ExperimentalDesignBureau-1571/fpv-ground-control-station/Універсальний_кейс_та_корпус_станції/README_EN.md

[🇺🇸 Read in English](README_EN.md) | [🇺🇦 Читати Українською](README.md)

# Universal Case and Station Body

The design of the universal case is developed as a balanced solution for transporting and deploying an FPV drone ground control station in field conditions. The primary focus of the design is on combining reliability, mobility, and manufacturing accessibility.

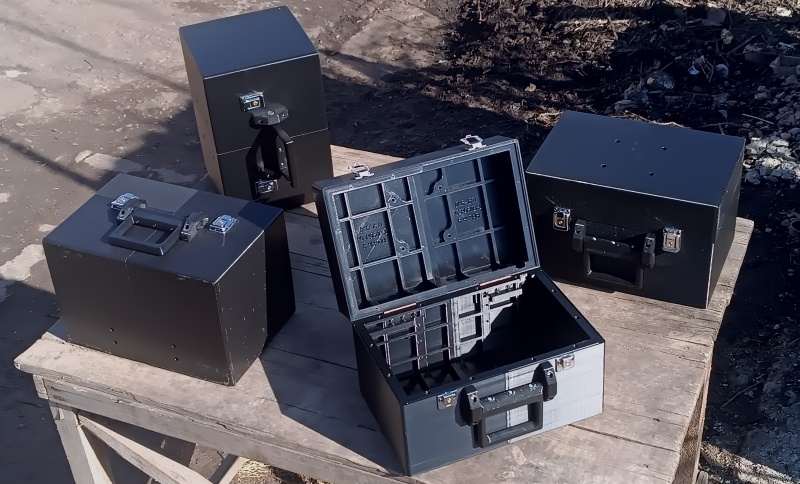
[picture p10: Універсальний_кейс_та_корпус_станції/Фото/general_view_of_finished_cases.jpg]
General view of finished cases


## Key Design Features:
<ul>
<li><b>Compactness and Mobility:</b> The body dimensions are optimized to ensure maximum operator mobility. The compact form factor allows the station to be conveniently transported in a backpack or as a separate small-sized equipment unit.</li>

<li><b>Optimization for Additive Manufacturing:</b> The geometry of the parts is designed for 3D printing on most common FDM printers. The maximum dimensions of individual elements do not exceed 250 × 250 × 250 mm, making the project accessible for implementation on budget equipment.</li>

<li><b>Economic Efficiency:</b> The development follows the principle of maximizing production cost reduction. The use of affordable materials (plastics like PETG/ABS) and standard hardware (fasteners) significantly lowers the cost of the finished product without sacrificing functionality.</li>

<li><b>Operational Durability and Repeatability:</b> The structure has a sufficient safety margin for intensive use. Technical solutions allow for easy replication of the body in local or field workshops.</li>

<li><b>Modular Architecture and Maintainability:</b></li>
<ul>
<li>The body consists of individual interchangeable modules.</li>

<li>High maintainability: in case of mechanical damage, it is sufficient to replace only the specific affected element.</li>

<li>Standardization of fasteners: Most connections are implemented using standard metric fasteners (M3 screws and nuts), simplifying assembly and component logistics.</li>
</ul>
</ul>

## Required Components for Manufacturing One Universal Case / Station Body

| Name | Type/Size | Quantity | Note |
|:---: | :---: | :---: |:---: |
| Self-tapping screw | 2x8 DIN 7982 | 12 pcs | If using the case as a station body |
| Screw | M3x14 DIN 7985 | 48 pcs | |
| Screw | M3x20 DIN 7985 A2 | 10 pcs | If using the case as a station body |
| Screw | M3x25 DIN 912 | 7 pcs | |
| Screw | M4x12 DIN 7985 | 4 pcs | If using the case as a station body |
| Nut | M3 DIN 934 | 65 pcs | |
| Washer | M3 DIN 125 | 18 pcs | |
| Lock with key | А-014/2 | 2 pcs | [Purchase lock with key А-014/2](https://prom.ua/ua/p2153719864-zamok-klyuchem-0142.html) |
| Hinges | В-114 | 2 pcs | [Purchase hinges В-114](https://prom.ua/ua/p779613844-petlya-114.html) |
| Part 1 |  | 1 pc | |
| Part 2 |  | 1 pc | |
| Part 3 |  | 1 pc | If using the case as a station body |
| Part 4 |  | 1 pc | If using the case as a station body |
| Part 5 |  | 1 pc | |
| Part 6 |  | 1 pc | |
| Part 7 |  | 2 pcs | |
| Part 8 |  | 1 pc | |
| Part 9 |  | 1 pc | |

## 3D Printing Settings and Material

| Parameter | Value |
| :---: | :---: |
| Perimeters | 5 |
| Top/Bottom solid layers | 5 |
| Infill density | 40% |
| Infill pattern | Gyroid |
| Supports | Tree |

Material: coPET black MonoFilament

## Detailed Hardware Allocation

| Name | Type/Size | Quantity | Note |
| :---: | :---: | :---: | :---: |
| Screw | M3x14 DIN 7985 | 11 pcs | Connecting Part 1 and Part 2 |
| Nut | M3 DIN 934 | 11 pcs | Connecting Part 1 and Part 2 |

Part 1 and Part 2

| Name | Type/Size | Quantity | Note |
| :---: | :---: | :---: | :---: |
| Screw | M3x14 DIN 7985 | 17 pcs | Connecting Part 5 and Part 6 |
| Nut | M3 DIN 934 | 17 pcs | Connecting Part 5 and Part 6 |

Part 5 and Part 6

| Name | Type/Size | Quantity | Note |
| :---: | :---: | :---: | :---: |
| Screw | M3x14 DIN 7985 | 8 pcs | Attaching locks to the top cover and the base of the case |
| Nut | M3 DIN 934 | 8 pcs | Attaching locks to the top cover and the base of the case |

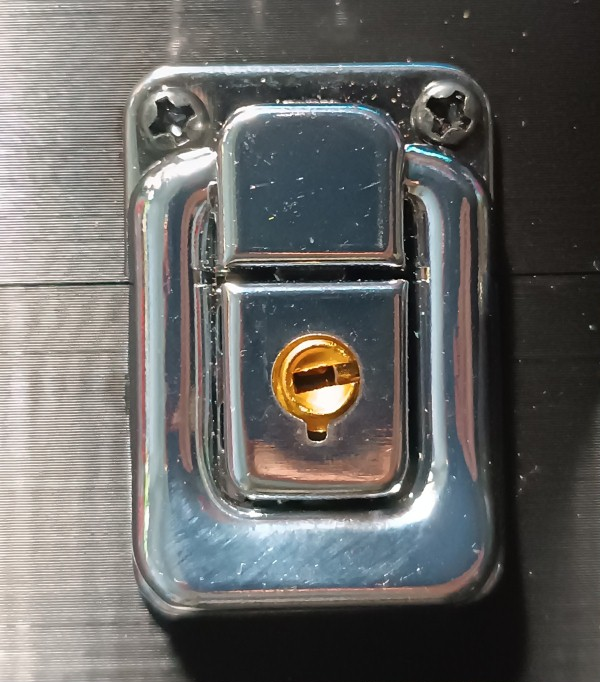
[picture p11: Універсальний_кейс_та_корпус_станції/Фото/fastening_the_lock.jpg]
Attaching locks


| Name | Type/Size | Quantity | Note |
| :---: | :---: | :---: | :---: |
| Screw | M3x14 DIN 7985 | 12 pcs | Attaching hinges to the top cover and the base of the case |
| Nut | M3 DIN 934 | 12 pcs | Attaching hinges to the top cover and the base of the case |
| Washer | M3 DIN 125 | 12 pcs | Attaching hinges to the top cover and the base of the case |

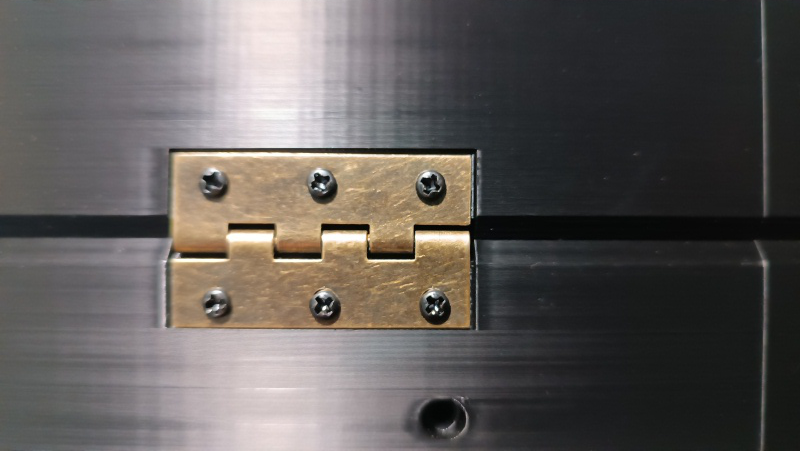
[picture p12: Універсальний_кейс_та_корпус_станції/Фото/hinge_attachment_1.jpg]
Hinge attachment 1
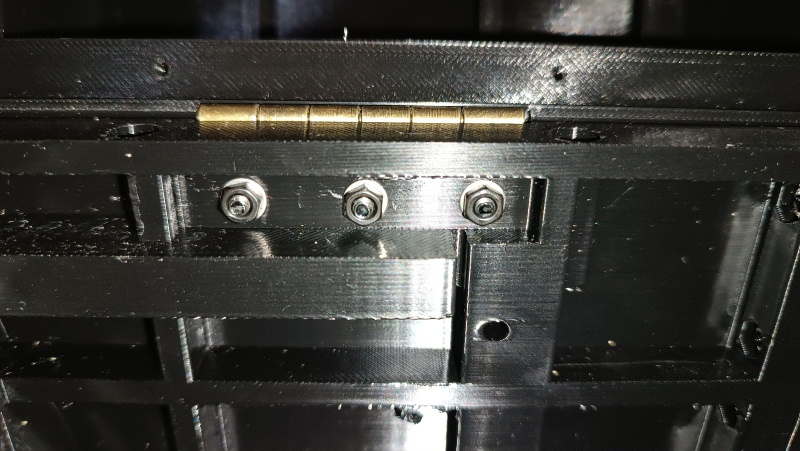
[picture p13: Універсальний_кейс_та_корпус_станції/Фото/hinge_attachment_2.jpg]
Hinge attachment 2
 

| Name | Type/Size | Quantity | Note |
| :---: | :---: | :---: | :---: |
| Screw | M3x25 DIN 912 | 3 pcs | Connecting Part 8 and Part 9 |
| Nut | M3 DIN 934 | 3 pcs | Connecting Part 8 and Part 9 |
| Washer | M3 DIN 125 | 6 pcs | Connecting Part 8 and Part 9 |

Part 8 and Part 9

| Name | Type/Size | Quantity | Note |
| :---: | :---: | :---: | :---: |
| Screw | M3x25 DIN 912 | 4 pcs | Connecting Part 7 to the base of the case |
| Nut | M3 DIN 934 | 4 pcs | Connecting Part 7 to the base of the case |

Connecting Part 7 to the base

| Name | Type/Size | Quantity | Note |
| :---: | :---: | :---: | :---: |
| Screw | M3x20 DIN 7985 A2 | 10 pcs | Attaching the Control Unit to the base of the case |
| Nut | M3 DIN 934 | 10 pcs | Attaching the Control Unit to the base of the case |

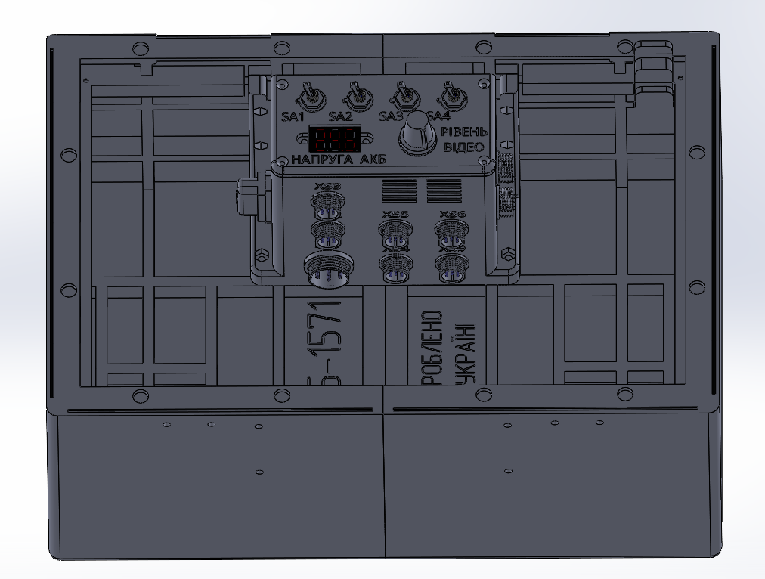
[picture p14: Універсальний_кейс_та_корпус_станції/picture/fastening_the_control_unit_to_the_base.png]
Attaching the Control Unit to the base


| Name | Type/Size | Quantity | Note |
| :---: | :---: | :---: | :---: |
| Screw | M4x12 DIN 7985 | 4 pcs | Attaching the monitor to the top cover of the case |

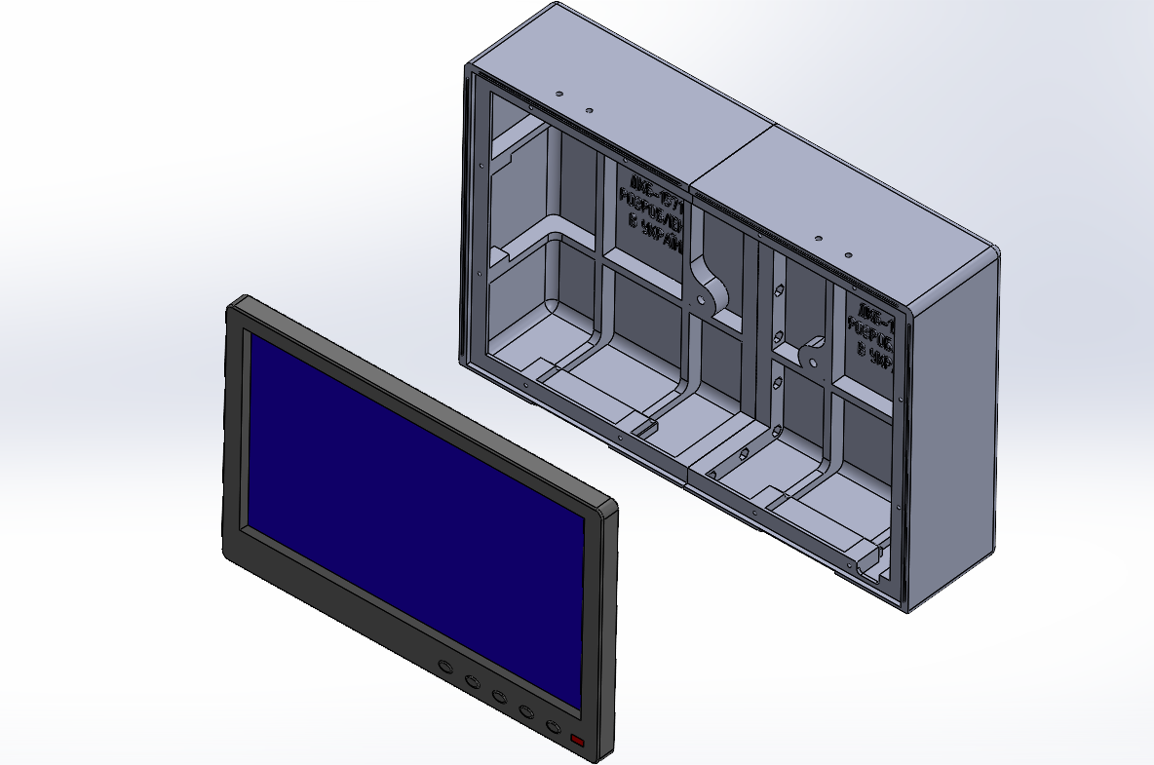
[picture p15: Універсальний_кейс_та_корпус_станції/picture/attaching_the_monitor_to_the_top_cover.png]
Attaching the monitor to the top cover


| Name | Type/Size | Quantity | Note |
| :---: | :---: | :---: | :---: |
| Self-tapping screw | 2x8 DIN 7982 | 6 pcs | Attaching Part 3 to Part 1 |
| Self-tapping screw | 2x8 DIN 7982 | 6 pcs | Attaching Part 4 to Part 2 |

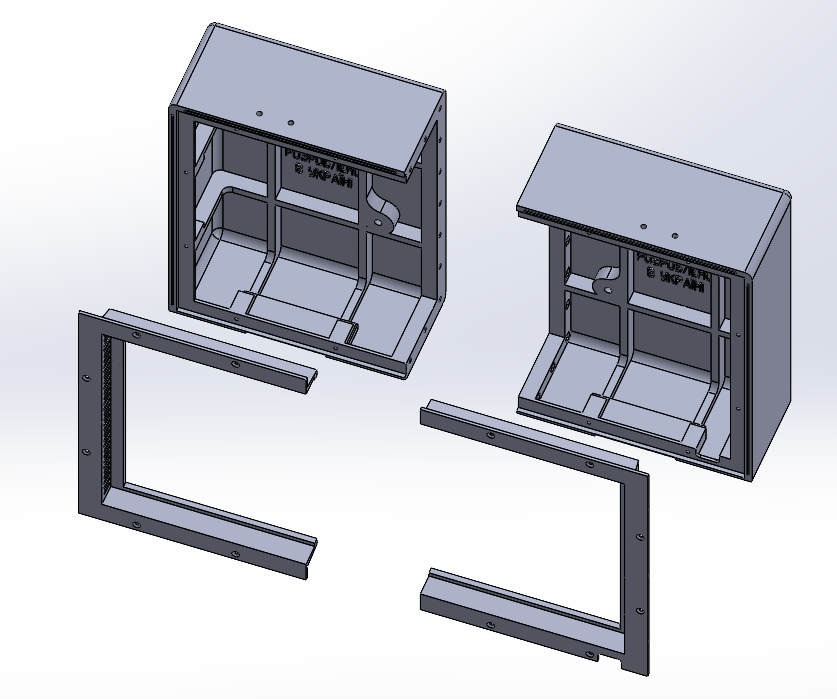
[picture p16: Універсальний_кейс_та_корпус_станції/Фото/fastening_parts_3_and_4_to_parts_1_and_2.png]
Attaching Parts 3 and 4
