ExperimentalDesignBureau-1571/fpv-ground-control-station/Підсистема керування/Адаптер JR-модуля/README.md

[🇺🇸 Read in English](README_EN.md) | [🇺🇦 Читати Українською](README.md)

# Адаптер JR-модуля

Адаптер JR-модуля забезпечує можливість підключення пульта керування з JR-сумісним відсіком до блоку керування станцією для подальшого двостороннього обміну інформацією з передавачем керування на виносному блоці станції.

Загальний вигляд JR-модуля

## Короткі технічні параметри

| Параметр | Значення | Примітка |
|---|---|---|
| Протокол керування | CRSF | Через S.Port |
| Інтерфейс передачі | Диференційний сигнал стандарту RS-485 | |
| Режим роботи | Двосторонній | Керування + телеметрія |
| Живлення адаптера JR-модуля | 5–8.4 В | Від пульта керування |
| Охолодження | Пасивне | Радіатори + вентиляційні отвори |
| Екранування | Часткове | |

### Інтерфейси

| Роз’єм | Призначення | Основні сигнали | Примітка |
|---|---|---|---|
| XS1 | Підключення до пульта керування | +BAT, GND, CRSF | Пульт керування має бути обладнаний JR-сумісним відсіком |
| XS2 | Підключення до блоку керування станцією | Диференційний сигнал стандарту RS-485, GND | |

## Схемотехніка та функціонал адаптера JR-модуля

Живлення адаптера здійснюється безпосередньо від пульта керування через роз’єм XS1 у діапазоні 5В–8,4В.

Високошвидкісний сигнал від пульта керування через вивід S.Port (протокол CRSF) роз’єму XS1 надходить на конвертер інтерфейсів (модуль BARVINOK-5 RS-485 nano V2.1), який перетворює його в диференційний сигнал стандарту RS-485 та через роз’єм XS2 видає в комутаційні лінії наземної станції. 

Стабілізацію температурних режимів пристрою забезпечує пасивна система охолодження, що складається з вентиляційних отворів у корпусі, силіконової термопрокладки та мідного радіатора. Радіатор електрично з’єднаний із загальним проводом (GND), що дозволяє йому виконувати функцію додаткового екрана для захисту від електромагнітних завад.

Принципова схема JR-модуля

## Перелік необхідних комплектуючих для виготовлення одного адаптера JR-модуля

| Найменування | Кількість| Примітка |
| :--- | :--- | :---: |
| Модуль конвертора інтерфейсів BARVINOK-5 RS-485 nano V2.1 | 1 штука | Модуль Українського виробництва [придбати BARVINOK-5 RS-485 nano V2.1 у виробника](https://prom.ua/ua/p2693881056-adapter-port-485.html) |
| Роз'єм PCE-C-05 | 1 штука | XS1 |
| Вилка блочна GX12-6 pin (male) | 1 штука | XS2 |
| Макетна плата під пайку двостороння з кроком 2,54 мм | 30 мм х 70 мм |  |
| Листова мідь товщиною 0.8 мм | 25 мм х 28 мм |  |
| Силіконова термопрокладка 2 мм 6W\m.k | 25 мм х 28 мм |  |
| Провід мідний 26 AWG з силіконовою ізоляцією чорний | 260 мм |  |
| Провід мідний 26 AWG з силіконовою ізоляцією зелений | 170 мм |  |
| Провід мідний 26 AWG з силіконовою ізоляцією синій | 170 мм |  |
| Гвинт M2x5 DIN 7985 | 2 штуки |  |
| Гвинт M2x6 DIN 965 | 3 штуки |  |
| Гвинт M2x10 DIN 7985 | 9 штук |  |
| Шайба M2 DIN 125 | 8 штук |  |
| Гайка M2 DIN 934 | 14 штук |  |
| Гвинт M3x8 DIN 965 | 2 штуки |  |
| Гайка M3 DIN 934 | 2 штуки |  |
| Деталь 1 - 3D друк | 1 штука |  |
| Деталь 2 - 3D друк | 1 штука |  |
| Деталь 3 - 3D друк | 1 штука |  |
| Деталь 4 - 3D друк | 1 штука |  |

## Налаштування 3Д-друку та використаний матеріал

| Параметр | Значення |
| :---: | :---: |
| Кількість периметрів | 4 |
| Суцільних шарів зверху і знизу | 5 |
| Щільність заповнення | 40% |
| Малюнок заповнення | Гіроїд |
| Підтримка | Деревоподібна |

Матеріал coPET black MonoFilament

## Деталізація по витраті метизів

| Найменування | Тип/Розмір | Кількість | Примітка |
| :--- | :--- | :---: | :---: |
| Гвинт | M2x5 DIN 7985 | 2 штуки | Кріплення плати з роз'ємом XS1 |
| Гайка | M2 DIN 934 | 2 штуки | Кріплення плати з роз'ємом XS1 |
| Гвинт | M2x10 DIN 7985 | 1 штука | Кріплення фіксатора роз'єму XS1 |
| Гайка | M2 DIN 934 | 1 штука | Кріплення фіксатора роз'єму XS1 |
| Гвинт | M3x8 DIN 965 | 2 штуки | Кріплення модуля BARVINOK-5 RS-485 nano V2.1 |
| Гайка | M3 DIN 934 | 2 штуки | Кріплення модуля BARVINOK-5 RS-485 nano V2.1 |
| Гвинт | M2x5 DIN 7985 | 4 штуки | Кріплення радіатора |
| Шайба | M2 DIN 125 | 4 штуки | Кріплення радіатора |
| Гайка | M2 DIN 934 | 4 штуки | Кріплення радіатора |
| Гвинт | M2x6 DIN 965 | 3 штуки | Кріплення внутрішньої планки до основи модуля |
| Гайка | M2 DIN 934 | 3 штуки | Кріплення внутрішньої планки до основи модуля |
| Гвинт | M2x10 DIN 7985 | 4 штуки | Кріплення кришки модуля до його основи |
| Шайба | M2 DIN 125 | 4 штуки | Кріплення кришки модуля до його основи |
| Гайка | M2 DIN 934 | 4 штуки | Кріплення кришки модуля до його основи |

## Деталізація по витраті проводу
| Тип | Довжина | Примітка |
| :--- | :--- | :---: |
| 26 AWG чорний | 80 мм | XS1 - конвертор інтерфейсів |
| 26 AWG зелений | 80 мм | XS1 - конвертор інтерфейсів |
| 26 AWG синій | 80 мм | XS1 - конвертор інтерфейсів |
| 26 AWG чорний | 90 мм | Конвертор інтерфейсів - XS2 |
| 26 AWG зелений | 90 мм | Конвертор інтерфейсів - XS2 |
| 26 AWG синій | 90 мм | Конвертор інтерфейсів - XS2 |
| 26 AWG чорний | 90 мм | XS2 - радіатор |
