ExperimentalDesignBureau-1571/fpv-ground-control-station/Виносний_блок/Кронштейн виносного блоку/README_EN.md

[🇺🇸 Read in English](README_EN.md) | [🇺🇦 Читати Українською](README.md)

# Remote Unit Bracket

The bracket is designed for mounting the ground control station's remote unit on a mast or other supporting structures. The bracket is part of the mechanical integration system of the remote unit. The design is oriented towards field operation and transportation. The general view of the remote unit with additional antennas fixed via the bracket on a mast is shown in the picture.

General view of the remote unit with additional antennas on the mast

The bracket design ensures:
- rapid deployment
- fixing the remote unit
- mounting rods for installing additional antenna systems or equipment
- increasing the antenna installation height
- expanding the antenna configuration according to operating conditions

## Short Technical Parameters

| Parameter | Value | Note |
|---|---|---|
| Mounting Type | On a mast | Metal clamps |
| Design Type | Modular | |
| Rods for additional antennas and equipment | Interchangeable | |

## List of Required Components for Manufacturing One Bracket

| Name | Quantity | Note |
| :--- | :--- | :---: |
| Screw | M3x35 DIN 7985 | 2 pcs | |
| Screw | M3x40 DIN 7985 | 4 pcs | |
| Screw | M3x50 DIN 7985 | 6 pcs | |
| M3 DIN 9021 Washer | 24 pcs | |
| M3 DIN 315 Wing nut | 12 pcs | |
| Tightening clamp 28-48 mm DIN3017-1 | 3 pcs | |
| Aluminum profile pipe 20x20x2 mm | 500 mm | |
| Part 1 - 3D print | 1 pc | |
| Part 2 - 3D print | 1 pc | |
| Part 3 - 3D print | 1 pc | |
| Part 4 - 3D print | 1 pc | |

## 3D Printing Settings and Material

| Parameter | Value |
| :---: | :---: |
| Perimeters | 4 |
| Top/Bottom solid layers | 5 |
| Infill density | 40% |
| Infill pattern | Gyroid |
| Supports | Tree |

Material: coPET black MonoFilament

## Hardware Usage Detail

| Name | Type/Size | Quantity | Note |
| :--- | :--- | :---: | :---: |
| Screw | M3x40 DIN 7985 | 4 pcs | Attaching rods to the bracket |
| Washer | M3 DIN 9021 | 8 pcs | Attaching rods to the bracket |
| Wing nut | M3 DIN 315 | 4 pcs | Attaching rods to the bracket |
| Screw | M3x50 DIN 7985 | 2 pcs | Attaching the control antenna bracket |
| Washer | M3 DIN 9021 | 4 pcs | Attaching the control antenna bracket |
| Wing nut | M3 DIN 315 | 2 pcs | Attaching the control antenna bracket |
| Screw | M3x35 DIN 7985 | 2 pcs | Attaching the helical antenna bracket |
| Washer | M3 DIN 9021 | 4 pcs | Attaching the helical antenna bracket |
| Wing nut | M3 DIN 315 | 2 pcs | Attaching the helical antenna bracket |
| Screw | M3x50 DIN 7985 | 4 pcs | Attaching the bracket to the concentrator |
| Washer | M3 DIN 9021 | 8 pcs | Attaching the bracket to the concentrator |
| Wing nut | M3 DIN 315 | 4 pcs | Attaching the bracket to the concentrator |
| Tightening clamp | Tightening clamp 28-48 mm DIN3017-1 | 3 pcs | Attaching the bracket to the mast |
