ExperimentalDesignBureau-1571/fpv-ground-control-station/Виносний_блок/Універсальна_рамка/README_EN.md

[🇺🇸 Read in English](README_EN.md) | [🇺🇦 Читати Українською](README.md)

# Universal Frame

The universal frame is designed for the mounting and mechanical integration of the remote unit concentrator and peripheral devices. The remote unit concentrator, along with the peripheral devices installed on the universal frame, forms the ground station's remote unit.

The design of the frame ensures:
- installation of the remote unit concentrator
- installation of TX and VRX blocks
- unified mounting of system components
- quick transition of the remote unit between transport and working positions

General view of the remote unit

## Design Features

- The design has a modular architecture
- Provision is made for the installation of interchangeable TX and VRX blocks
- All modules are fixed with screw connections
- The design ensures resistance to mechanical loads and vibrations

## Transport Position

The transport position of the remote unit in the ground station case provides for:
- dismounted stand
- absence of a VRX block in the additional slot
- fixed position of peripheral devices

Transport position of the remote unit

## List of Required Components for Manufacturing One Universal Frame

| Name | Quantity | Note |
| :--- | :--- | :---: |
| M2x10 DIN 7985 Screw | 12 pcs | Peripheral device mounting |
| M2 DIN 934 Nut | 12 pcs | Peripheral device mounting |
| M3x14 DIN 7985 A2 Screw | 2 pcs | Remote unit handle mounting |
| M3x20 DIN 7985 A2 Screw | 2 pcs | Stand mounting |
| M3x30 DIN 965 Screw | 5 pcs | Mounting the universal frame to the concentrator |
| M3 DIN 934 Nut | 9 pcs | Mounting the universal frame to the concentrator, stand mounting, remote unit handle mounting |
| M3 DIN 315 Wing nut | 2 pcs | Stand mounting |
| 2x8 DIN 7982 Self-tapping screw | 2 pcs | Antenna holder mounting |
| Part 1 - 3D print | 1 pc |  |
| Part 2 - 3D print | 1 pc |  |
| Part 3 - 3D print | 1 pc |  |
| Part 4 - 3D print | 1 pc |  |

## 3D Printing Settings and Material

| Parameter | Value |
| :---: | :---: |
| Perimeters | 4 |
| Top/Bottom solid layers | 5 |
| Infill density | 40% |
| Infill pattern | Gyroid |
| Supports | Tree |

Material: coPET black MonoFilament
