ExperimentalDesignBureau-1571/fpv-ground-control-station/Підсистема керування/Адаптер JR-модуля/temp.md

# Загальний опис

Адаптер JR-модуля забезпечує можливість підключення пульта керування з JR-сумісним відсіком до блоку керування станцією для подальшого двостороннього обміну інформацією з передавачем керування на виносному блоці станції.

Загальний вигляд JR-модуля

## Схемотехніка та функціонал адаптера JR-модуля

Живлення адаптера здійснюється безпосередньо від пульта керування через роз’єм XS1 у діапазоні 5В–8,4В.

Високошвидкісний сигнал від пульта керування через вивід S.Port (протокол CRSF) роз’єму XS1 надходить на конвертер інтерфейсів (модуль BARVINOK-5 RS-485), який перетворює його в диференційний сигнал стандарту RS-485 та через роз’єм XS2 видає в комутаційні лінії наземної станції. 

Стабілізацію температурних режимів пристрою забезпечує пасивна система охолодження, що складається з вентиляційних отворів у корпусі, силіконової термопрокладки та мідного радіатора. Радіатор електрично з’єднано із загальним проводом (GND), що дозволяє йому виконувати функцію додаткового екрана для захисту від електромагнітних завад.

Принципова схема JR-модуля

## Перелік необхідних комплектуючих для виготовлення одного JR-модуля

| Найменування | Кількість| Примітка |
| :--- | :--- | :---: |

## Налаштування 3Д-друку та використаний матеріал

| Параметр | Значення |
| :---: | :---: |
| Кількість периметрів | 4 |
| Суцільних шарів зверху і знизу | 5 |
| Щільність заповнення | 40% |
| Малюнок заповнення | Гіроїд |
| Підтримка | Деревоподібна |

Матеріал coPET black MonoFilament

## Деталізація по витраті метизів

| Найменування | Тип/Розмір | Кількість | Примітка |
| :--- | :--- | :---: | :---: |

## Деталізація по витраті проводу
| Тип | Довжина | Примітка |
| :--- | :--- | :---: |
| 20 AWG чорний | 100 мм | XS1 - шина GND модуля розподілу живлення |
