ExperimentalDesignBureau-1571/fpv-ground-control-station/Блоки_VRX/README.md

[🇺🇸 Read in English](README_EN.md) | [🇺🇦 Читати Українською](README.md)

# Блоки VRX

Розділ містить документацію, 3D-моделі, принципові схеми та інструкції з виготовлення змінних блоків прийому відеосигналу (VRX блоків), що використовуються у складі наземної станції керування. Кожен VRX блок є функціонально завершеним модулем, призначеним для роботи в певному частотному діапазоні, стандарті передачі або з конкретним типом відеоприймального обладнання.

## Призначення

VRX блоки забезпечують:
- прийом відеосигналу
- передачу вихідного відеосигналу в комутаційні лінії наземної станції
- механічну інтеграцію відеоприймального обладнання у виносний блок станції
- уніфіковане підключення живлення та сигнальних ліній

## Архітектура та особливості реалізації

### Архітектура допускає використання:
<ul>
<li>аналогових відеоприймачів</li>
<li>цифрових відеоприймальних систем в комбінації з конвертором відеосигналу</li>
<li>керування відеоприймачем через комутаційні лінії наземної станції</li>
</ul>

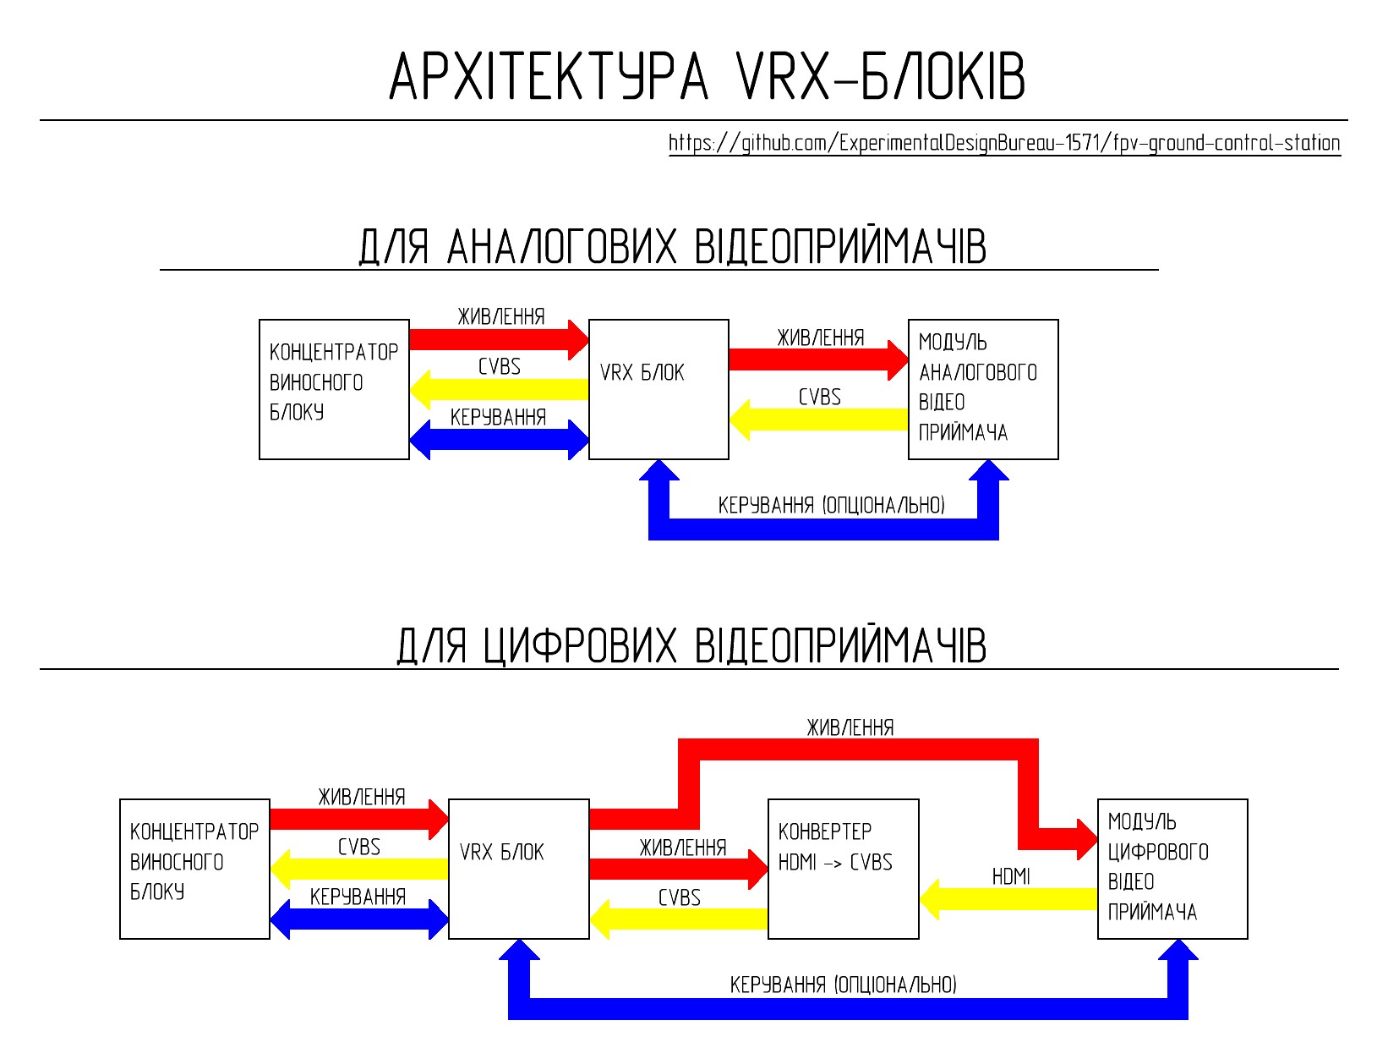
[picture p26: Блоки_VRX/VRX_block_architecture.JPG]
Блок-схема архітектури VRX блоків


### Особливості реалізації
<ul>
<li>Всі VRX блоки мають уніфіковане підключення до концентратора виносного блоку </li>
<li>Нові VRX блоки інтегруються в наземну станцію без зміни архітектури інших підсистем</li>
<li>Кожен VRX блок проектується під конкретний тип відеоприймального обладнання або стандарт передачі </li>
<li>Конструкція забезпечує заміну VRX блоків без модифікації інших компонентів станції </li>
</ul>
