ExperimentalDesignBureau-1571/fpv-ground-control-station/Підсистема керування/README.md

[🇺🇸 Read in English](README_EN.md) | [🇺🇦 Читати Українською](README.md)

# Підсистема керування

Підсистема керування забезпечує двосторонній обмін даними через комутаційні лінії наземної станції за стандартом RS-485 між пультом керування оператора та передавачем керування, що встановлений у виносному блоці наземної станції.

До складу підсистеми керування входять:
- Адаптер JR-модуля (зі сторони пульта керування)
- Блок TX (зі сторону виносного блоку)

## Короткі технічні параметри

| Параметр | Значення | Примітка |
|---|---|---|
| Протокол керування | CRSF | Через S.Port |
| Інтерфейс передачі | Диференційний сигнал стандарту RS-485 | Стійкий до завад, довгі лінії |
| Канал передачі даних | Комутаційні лінії наземної станції | Максимальна довжина залежить від типу кабеля |
| Режим роботи | Двосторонній | Керування + телеметрія |
| Живлення адаптера JR-модуля | 5–8.4 В | Від пульта керування |
| Живлення блоку TX | Від концентратора виносного блоку | Через XS2 |
| Живлення модуля TX передавача керування | 8В | Від блоку ТХ |
| Вихідна напруга блоку TX через роз'єм XS3 | 8В | Максимальний довготривалий струм 2А |
| Охолодження | Пасивне | Радіатори + вентиляційні отвори |
| Екранування | Часткове | |

## Принцип роботи та архітектура

Сигнал керування від пульта надходить на адаптер JR-модуля, де перетворюється в диференційний сигнал стандарту RS-485. Далі сигнал передається через комутаційні лінії наземної станції до блоку TX, де відбувається зворотне перетворення в сигнал протоколу CRSF перед подачею на передавач керування. Зворотний канал (телеметрія) працює аналогічно у протилежному напрямку.

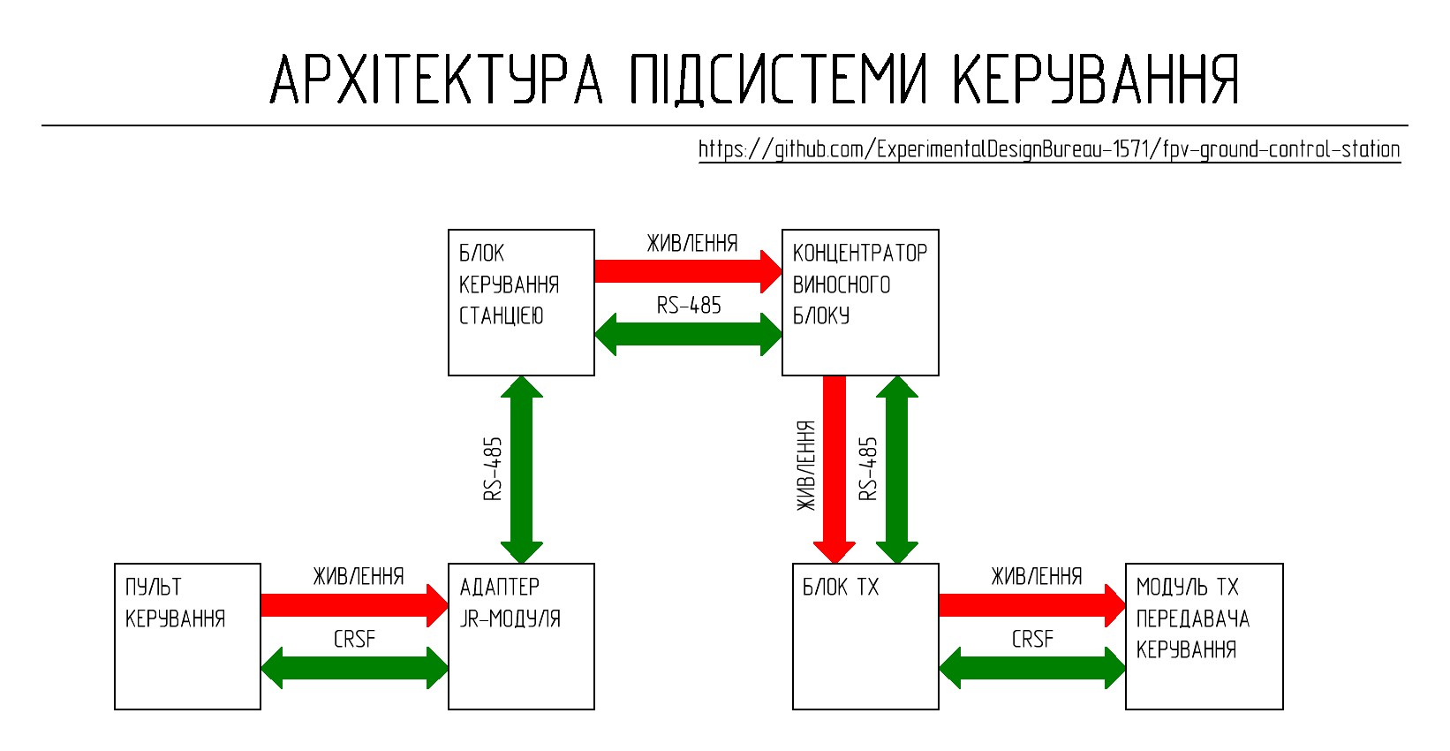
[picture p27: Підсистема керування/control_subsystem_architecture_block_diagram.JPG]
Блок-схема архітектури підсистеми керування


Детальна реалізація кожного пристрою підсистеми керування наведена у відповідних розділах:

* **[Адаптер JR-модуля](Адаптер%20JR-модуля/)**
* **[Блок TX](Блок%20TX/)**
