ExperimentalDesignBureau-1571/fpv-ground-control-station/Виносний_блок/README.md

[🇺🇸 Read in English](README_EN.md) | [🇺🇦 Читати Українською](README.md)

# Виносний блок

Виносний блок є функціональним вузлом наземної станції керування, призначеним для інтеграції систем прийому відеосигналу, передачі сигналів керування, а також антенно-фідерного обладнання. Виносний блок є модульною платформою та допускає зміну конфігурації залежно від задачі, типу відеосистеми або умов експлуатації.

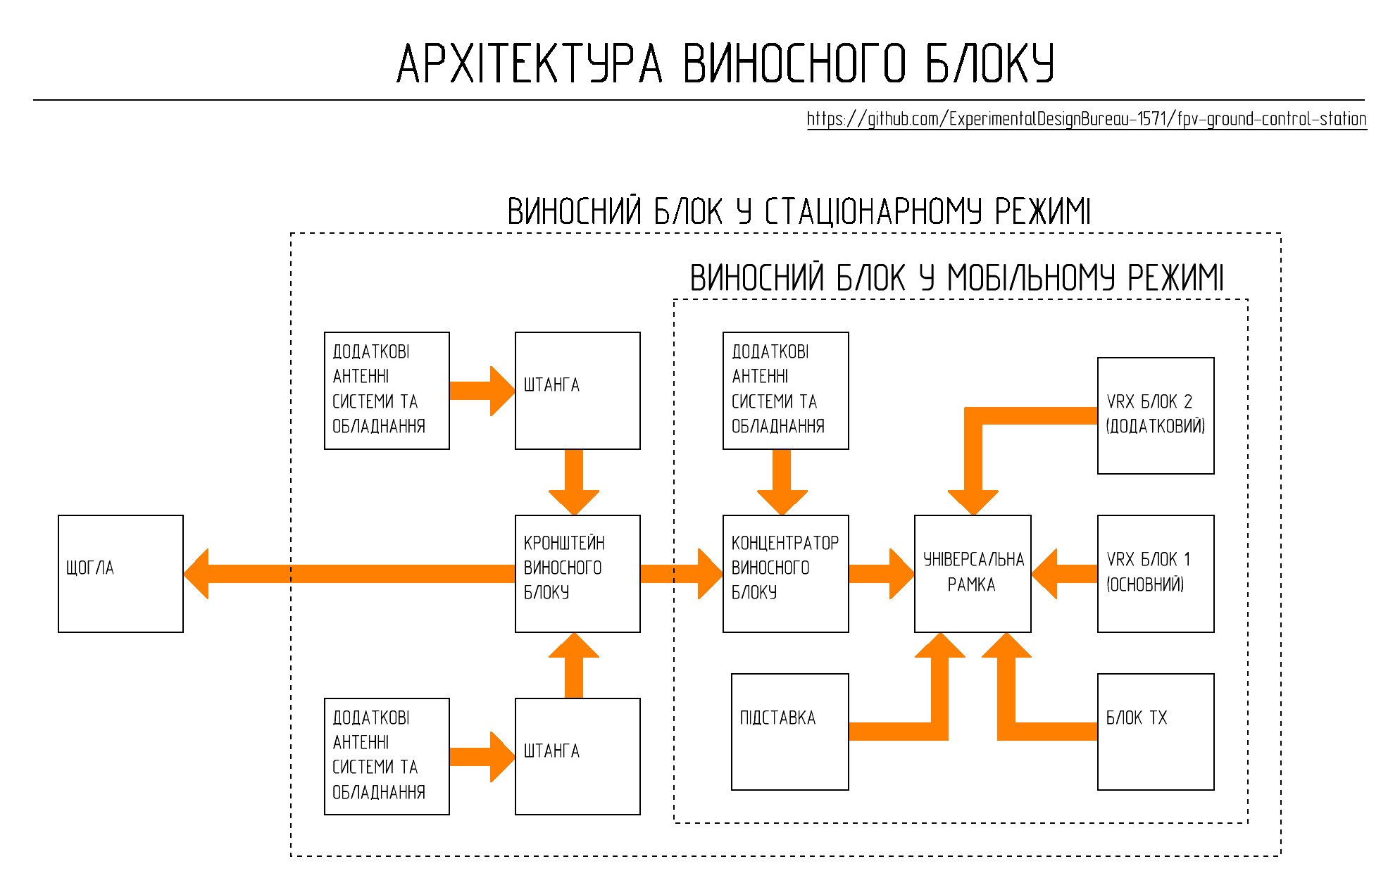
[picture p28: Виносний_блок/remote_unit_architecture.JPG]
Архітектура виносного блоку


Конструкція виносного блоку забезпечує:
- механічну та електричну інтеграцію периферійних пристроїв виносного блоку
- використання змінних TX та VRX блоків
- зміну конфігурації периферійних пристроїв без зміни архітектури інших підсистем станції
- винесення високочастотних модулів за межі блоку керування станції
- інтеграцію додаткових антенних систем
- експлуатацію в мобільному та стаціонарному режимах
- монтаж на щоглу або інші несучі конструкції
- швидке переведення станції між транспортним та робочим положенням

## Режими експлуатації

### Мобільний режим

Виносний блок може використовуватись без встановлення на щоглу при роботі в умовах високої мобільності або при наявності прямої видимості.

### Стаціонарний режим

Для покращення умов прийому та передачі сигналу виносний блок може встановлюватись на щоглу за допомогою кронштейна разом з додатковими антенними системами.

### Примітка

Рекомендується дотримуватись наступного порядку виготовлення виносного блоку:

1.	**[Концентратор виносного блоку](Концентратор_виносного_блоку/)**
2.	**[Універсальна рамка](Універсальна_рамка/)**
3.	**[Кронштейн виносного блоку](Кронштейн%20виносного%20блоку/)**
