ExperimentalDesignBureau-1571/fpv-ground-control-station/Виносний_блок/Універсальна_рамка/README.md

[🇺🇸 Read in English](README_EN.md) | [🇺🇦 Читати Українською](README.md)

# Універсальна рамка

Універсальна рамка призначена для монтажу та механічної інтеграції концентратора виносного блоку та периферійних пристроїв. Концентратор виносного блоку разом з встановленими на універсальній рамці периферійними пристроями формує виносний блок наземної станції.

Конструкція рамки забезпечує:
- встановлення концентратора виносного блоку
- встановлення блоку TX та VRX блоків
- уніфіковане кріплення компонентів системи
- швидке переведення виносного блоку між транспортним та робочим положенням

Загальний вигляд виносного блоку

## Особливості конструкції

- Конструкція має модульну архітектуру
- Передбачено встановлення змінних блоків TX та VRX блоків
- Всі модулі фіксуються гвинтовими з’єднаннями
- Конструкція забезпечує стійкість до механічних навантажень та вібрацій

## Транспортне положення

Транспортне положення виносного блоку в корпусі наземної станції передбачає:
- демонтовану підставку
- відсутність VRX блоку в додатковому слоті
- фіксоване положення периферійних пристроїв

Транспортне положення виносного блоку

## Перелік необхідних комплектуючих для виготовлення однієї універсальної рамки

| Найменування | Кількість| Примітка |
| :--- | :--- | :---: |
| Гвинт M2x10 DIN 7985 | 12 штук | Кріплення периферійних пристроїв |
| Гайка M2 DIN 934 | 12 штук | Кріплення периферійних пристроїв |
| Гвинт M3x14 DIN 7985 A2 | 2 штуки | Кріплення ручки виносного блоку |
| Гвинт M3x20 DIN 7985 A2 | 2 штуки | Кріплення підставки |
| Гвинт M3x30 DIN 965 | 5 штуки | Кріплення універсальної рамки до концентратора |
| Гайка M3 DIN 934 | 9 штуки | Кріплення універсальної рамки до концентратора, кріплення підставки, кріплення ручки виносного блоку |
| Гайка баранцева M3 DIN 315 | 2 штуки | Кріплення підставки |
| Шуруп 2х8 DIN 7982 | 2 штуки | Кріплення фіксатора антен |
| Деталь 1 - 3D друк | 1 штука |  |
| Деталь 2 - 3D друк | 1 штука |  |
| Деталь 3 - 3D друк | 1 штука |  |
| Деталь 4 - 3D друк | 1 штука |  |

## Налаштування 3Д-друку та використаний матеріал

| Параметр | Значення |
| :---: | :---: |
| Кількість периметрів | 4 |
| Суцільних шарів зверху і знизу | 5 |
| Щільність заповнення | 40% |
| Малюнок заповнення | Гіроїд |
| Підтримка | Деревоподібна |

Матеріал coPET black MonoFilament
