ExperimentalDesignBureau-1571/fpv-ground-control-station/Виносний_блок/temp.md

# Загальний опис

Кронштейн призначений для монтажу виносного блоку наземної станції керування на щоглі або інших несучих конструкціях. Кронштейн є частиною системи механічної інтеграції виносного блоку. Конструкція орієнтована на польову експлуатацію та транспортування. Загальний вигляд виносного блоку з додатковими антенами закріпленого через кронштейн на щоглі показано на картинці.

Конструкція кронштейна забезпечує:
- швидке розгортання
- фіксацію виносного блоку
- монтаж штанг для встановлення додаткових антен чи обладнання
- підвищення висоти встановлення антен
- розширення антенної конфігурації відповідно до умов експлуатації
- адаптацію конфігурації станції під умови експлуатації

## Короткі технічні параметри

| Параметр | Значення | Примітка |
|---|---|---|
| Тип монтажу | На щоглу | Металеві хомути |
| Тип конструкції | Модульна | |
| Штанги додаткових антен та обладнання | Змінні | |

## Перелік необхідних комплектуючих для виготовлення одного кронштейну

| Найменування | Кількість| Примітка |
| :--- | :--- | :---: |
| Гвинт | M3x32 DIN 7985 | 2 штуки |  |
| Гвинт | M3x40 DIN 7985 | 4 штуки |  |
| Гвинт | M3x50 DIN 7985 | 6 штук |  |
| Шайба M3 DIN 9021 | 24 штуки |  |
| Гайка баранцева M3 DIN 315 | 12 штук |  |
| Затяжний хомут 32-50 мм DIN3017-1 | 3 штуки |  |
| Труба профільна алюмінієва 20х20х2 мм | 500 мм |  |
| Деталь 1 - 3D друк | 1 штука |  |
| Деталь 2 - 3D друк | 1 штука |  |
| Деталь 3 - 3D друк | 1 штука |  |
| Деталь 4 - 3D друк | 1 штука |  |

## Деталізація по витраті метизів

| Найменування | Тип/Розмір | Кількість | Примітка |
| :--- | :--- | :---: | :---: |
| Гвинт | M3x40 DIN 7985 | 4 штуки | Кріплення штанг до кронштейну |
| Шайба | M3 DIN 9021 | 8 штук | Кріплення штанг до кронштейну |
| Гайка баранцева | M3 DIN 315 | 4 штуки | Кріплення штанг до кронштейну |
| Гвинт | M3x50 DIN 7985 | 2 штуки | Кріплення кронштейну антени керування |
| Шайба | M3 DIN 9021 | 4 штуки | Кріплення кронштейну антени керування |
| Гайка баранцева | M3 DIN 315 | 2 штуки | Кріплення кронштейну антени керування |
| Гвинт | M3x35 DIN 7985 | 2 штуки | Кріплення кронштейну спіральних антен |
| Шайба | M3 DIN 9021 | 4 штуки | Кріплення кронштейну спіральних антен |
| Гайка баранцева | M3 DIN 315 | 2 штуки | Кріплення кронштейну спіральних антен|
| Гвинт | M3x50 DIN 7985 | 4 штуки | Кріплення кронштейну до концентратора |
| Шайба | M3 DIN 9021 | 8 штук | Кріплення кронштейну до концентратора |
| Гайка баранцева | M3 DIN 315 | 4 штуки | Кріплення кронштейну до концентратора |
| Затяжний хомут | 32-50 мм DIN3017-1 | 3 штуки | Кріплення кронштейну до щогли |
