ExperimentalDesignBureau-1571/fpv-ground-control-station/Універсальний_кейс_та_корпус_станції/Фото/список_комплектуючих.md

<h1>Технічні особливості конструкції</h1>
Конструкція універсального кейса розроблена як збалансоване рішення для розгортання наземної станції керування FPV-дронами в польових умовах. Основний акцент при проєктуванні зроблено на поєднанні надійності, мобільності та доступності виробництва.

<h2>Ключові характеристики конструкції:</h2>
<ul>
<li><b>Компактність та мобільність:</b> Габарити корпусу оптимізовані для забезпечення максимальної мобільності оператора. Компактний форм-фактор кейса дозволяє зручно транспортувати станцію в рюкзаку або як окрему малогабаритну одиницю спорядження.</li>

<li><b>Оптимізація під адитивне виробництво:</b> Геометрія деталей розрахована на 3D-друк на більшості поширених FDM-принтерів. Максимальні габарити окремих елементів не перевищують 250 × 250 × 250 мм, що робить проєкт доступним для реалізації на бюджетному обладнанні.</li>

<li><b>Економічна ефективність:</b> При розробці закладено принцип максимального здешевлення виробництва. Використання доступних матеріалів (пластики типу PETG/ABS) та стандартної метизної продукції дозволяє значно знизити собівартість готового виробу без втрати функціональності.</li>

<li><b>Експлуатаційна стійкість та повторюваність:</b> Конструкція має достатній запас міцності для інтенсивного використання. Технічні рішення дозволяють легко відтворити корпус у локальних або польових майстернях.</li>

<li><b>Модульна архітектура та ремонтопридатність:</b></li>
<ul>
<li>Корпус складається з окремих взаємозамінних модулів.</li>

<li>Висока ремонтопридатність: у разі механічного пошкодження достатньо замінити лише конкретний елемент.</li>

<li>Уніфікація кріплень: Всі з’єднання реалізовані на базі стандартного метричного кріплення (гвинти та гайки M3), що спрощує збірку та логістику комплектуючих </li>
</ul>
</ul>

Необхідна кількість комплектуючих для виготовлення одного універсального кейсу - корпусу станції

| Найменування | Тип/Розмір | Кількість |
| :--- | :--- | :---: |
| Гвинт | M3x14 DIN 7985 | 48 штук |
| Гвинт | M3x25 DIN 912 | 7 штук |
| Гайка | M3 DIN 934 | 55 штук |
| Шайба | M3 DIN 125 | 18 штук |
| Замок з ключем | А-014/2 | 2 штуки |
| Навіси | В-114 | 2 штуки |

Деталізація по витраті метизів

| Найменування | Тип/Розмір | Кількість | Примітка |
| :--- | :--- | :---: | :---: |
| Гвинт | M3x14 DIN 7985 | 11 штук | З'єднання між собою Деталь 1 та Деталь 2 |
| Гайка | M3 DIN 934 | 11 штук | З'єднання між собою Деталь 1 та Деталь 2 |

Деталь 1 та Деталь 2

| Найменування | Тип/Розмір | Кількість | Примітка |
| :--- | :--- | :---: | :---: |
| Гвинт | M3x14 DIN 7985 | 17 штук | З'єднання між собою Деталь 5 та Деталь 6 |
| Гайка | M3 DIN 934 | 17 штук | З'єднання між собою Деталь 5 та Деталь 6 |

Деталь 5 та Деталь 6

| Найменування | Тип/Розмір | Кількість | Примітка |
| :--- | :--- | :---: | :---: |
| Гвинт | M3x14 DIN 7985 | 8 штук | Кріплення замків до вехньої кришки та основи універсального кейсу та корпусу станції |
| Гайка | M3 DIN 934 | 8 штук | Кріплення замків до вехньої кришки та основи універсального кейсу та корпусу станції |

| Найменування | Тип/Розмір | Кількість | Примітка |
| :--- | :--- | :---: | :---: |
| Гвинт | M3x14 DIN 7985 | 12 штук | Кріплення навісів до вехньої кришки та основи універсального кейсу та корпусу станції |
| Гайка | M3 DIN 934 | 12 штук | Кріплення навісів до вехньої кришки та основи універсального кейсу та корпусу станції |
| Шайба | M3 DIN 125 | 12 штук | Кріплення навісів до вехньої кришки та основи універсального кейсу та корпусу станції |

| Найменування | Тип/Розмір | Кількість | Примітка |
| :--- | :--- | :---: | :---: |
| Гвинт | M3x25 DIN 912 | 3 штуки | З'єднання між собою Деталь 8 та Деталь 9 |
| Гайка | M3 DIN 934 | 3 штуки | З'єднання між собою Деталь 8 та Деталь 9 |
| Шайба | M3 DIN 125 | 6 штук | З'єднання між собою Деталь 8 та Деталь 9 |

Деталь 8 та Деталь 9

| Найменування | Тип/Розмір | Кількість | Примітка |
| :--- | :--- | :---: | :---: |
| Гвинт | M3x25 DIN 912 | 4 штуки | З'єднання між собою Деталь 7 та основи універсального кейсу та корпусу станції |
| Гайка | M3 DIN 934 | 4 штуки | З'єднання між собою Деталь 7 та основи універсального кейсу та корпусу станції |

З'єднання між собою Деталь 7 та основи універсального кейсу та корпусу станції
