ExperimentalDesignBureau-1571/fpv-ground-control-station/assets/block_diagram/ground_station_architecture_block_diagram_en.JPG

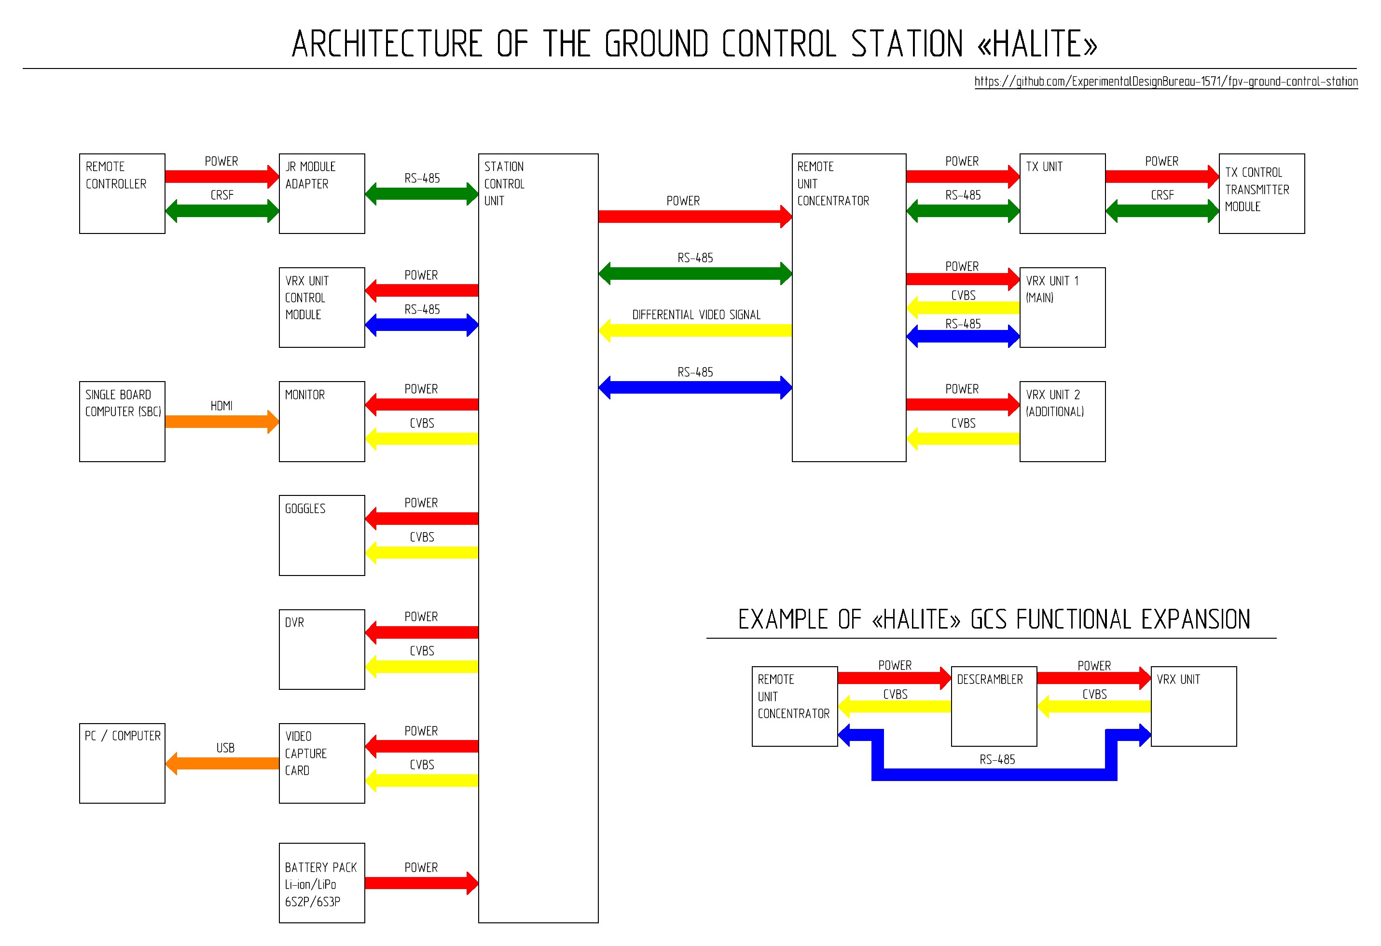
assets/block_diagram/ground_station_architecture_block_diagram_en.JPG
