ExperimentalDesignBureau-1571/fpv-ground-control-station/Блок_керування_станцією/drawing/drawing_large_radiator.JPG

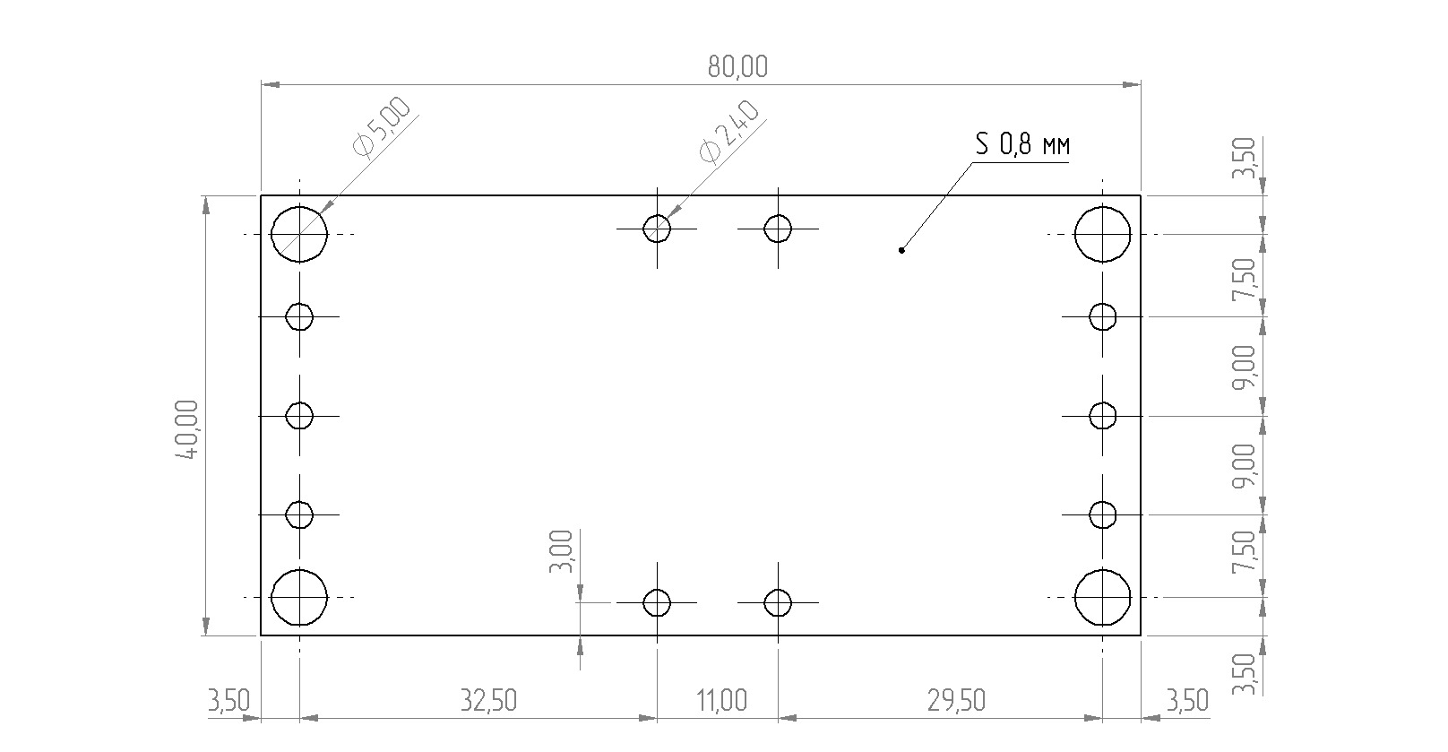
Блок_керування_станцією/drawing/drawing_large_radiator.JPG
