ExperimentalDesignBureau-1571/fpv-ground-control-station/Блок_керування_станцією/drawing/small_radiator_drawing.JPG

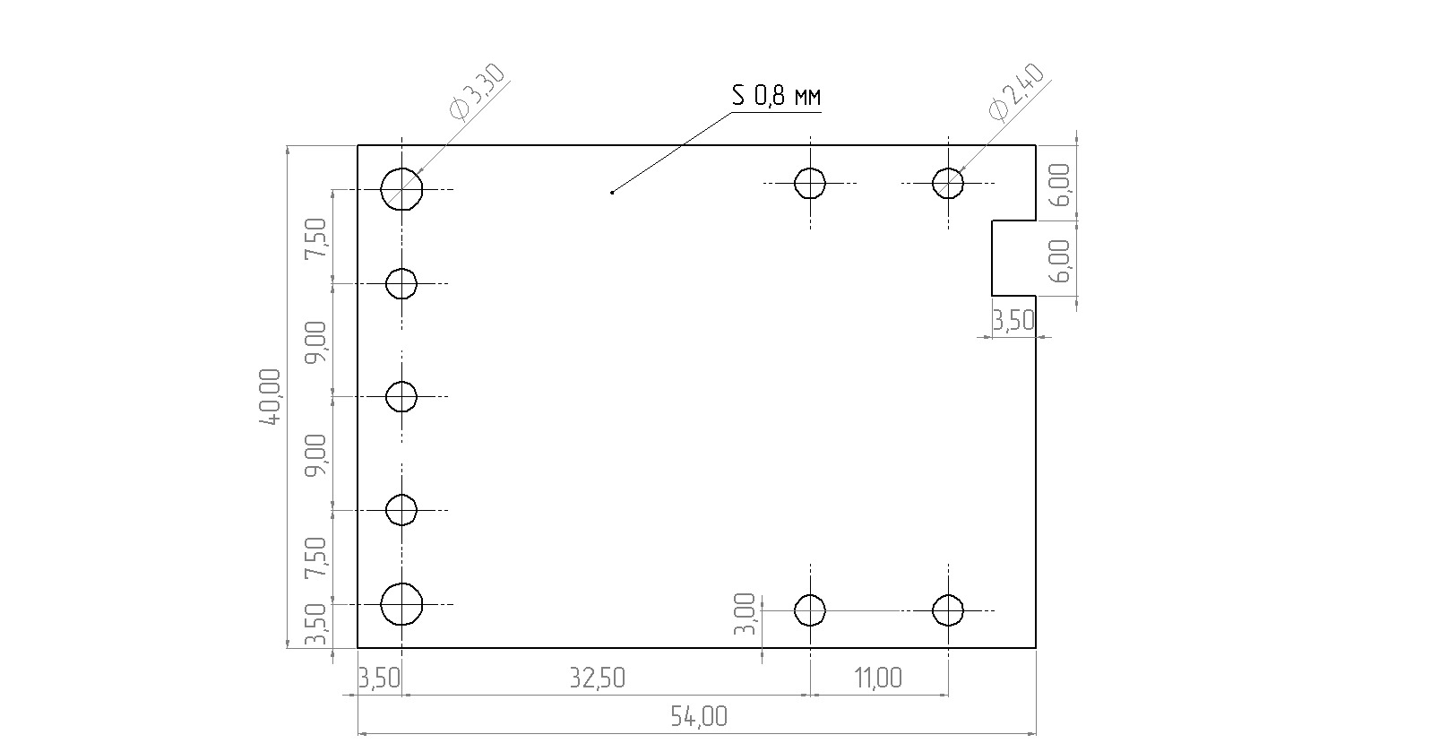
Блок_керування_станцією/drawing/small_radiator_drawing.JPG
