ExperimentalDesignBureau-1571/fpv-ground-control-station/Блок_керування_станцією/pcb-layout/layout-screenshot.png

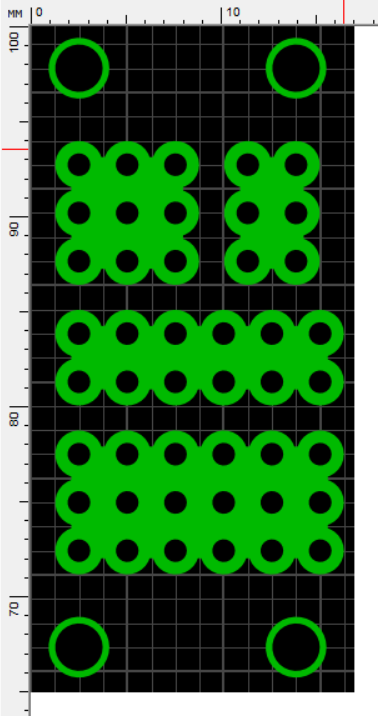
Блок_керування_станцією/pcb-layout/layout-screenshot.png
