ExperimentalDesignBureau-1571/fpv-ground-control-station/Блоки_VRX/Блок_на_базі_VRX_Readytosky_1.2G_1.3G/STL/Деталь_1_основа_блоку.STL

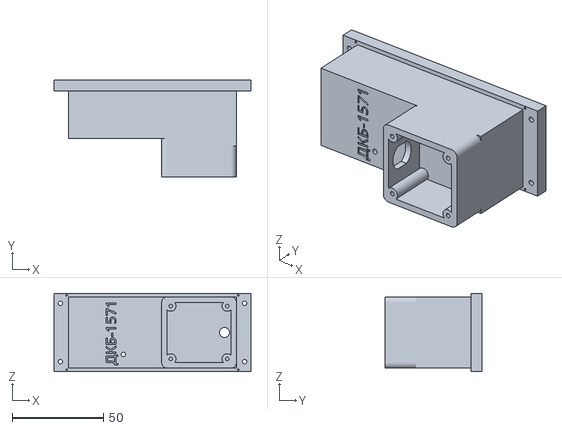
[picture p33: CAD file, 2026-05-03]
Блоки_VRX/Блок_на_базі_VRX_Readytosky_1.2G_1.3G/STL/Деталь_1_основа_блоку.STL
108.0 x 53.0 x 43.0
