ExperimentalDesignBureau-1571/fpv-ground-control-station/Блоки_VRX/Блок_на_базі_VRX_SKYZONE_SteadyView_X_5G/STL/Деталь_3_маскувальна_кришка.STL

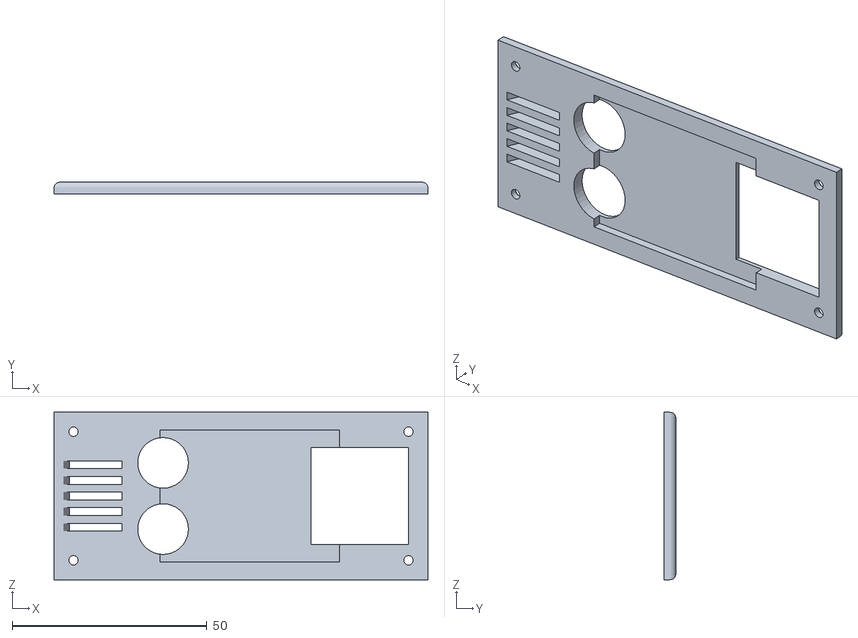
[picture p34: CAD file, 2026-04-06]
Блоки_VRX/Блок_на_базі_VRX_SKYZONE_SteadyView_X_5G/STL/Деталь_3_маскувальна_кришка.STL
96.0 x 3.00 x 43.0
