ExperimentalDesignBureau-1571/fpv-ground-control-station/Виносний_блок/Концентратор_виносного_блоку/STL/Деталь_3_кришка_блоку_роз'ємів_концентратора.STL

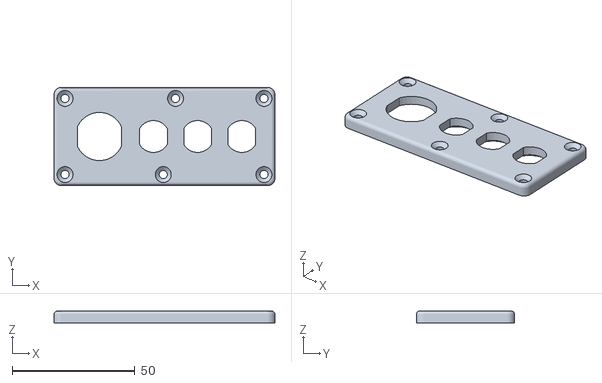
[picture p35: CAD file, 2026-04-06]
Виносний_блок/Концентратор_виносного_блоку/STL/Деталь_3_кришка_блоку_роз'ємів_концентратора.STL
90.0 x 40.0 x 5.00
