ExperimentalDesignBureau-1571/fpv-ground-control-station/Виносний_блок/Універсальна_рамка/STL/Деталь_3_ручка_виносного_блоку.STL

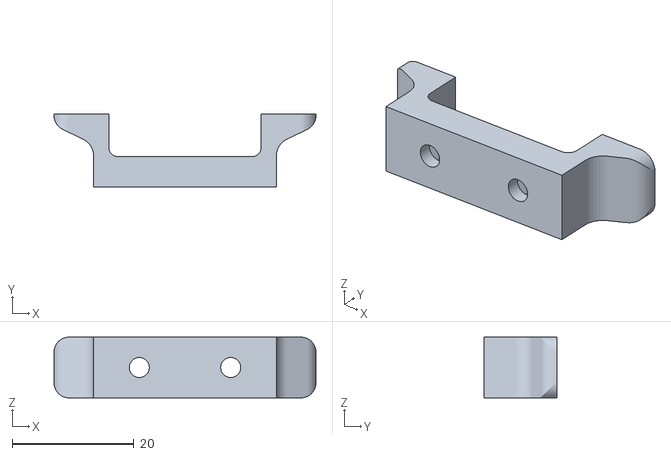
[picture p36: CAD file, 2026-04-06]
Виносний_блок/Універсальна_рамка/STL/Деталь_3_ручка_виносного_блоку.STL
43.0 x 12.0 x 10.0
