ExperimentalDesignBureau-1571/fpv-ground-control-station/Універсальний кейс та корпус станції/STL/Деталь 2 кришка кейсу верхня права.STL

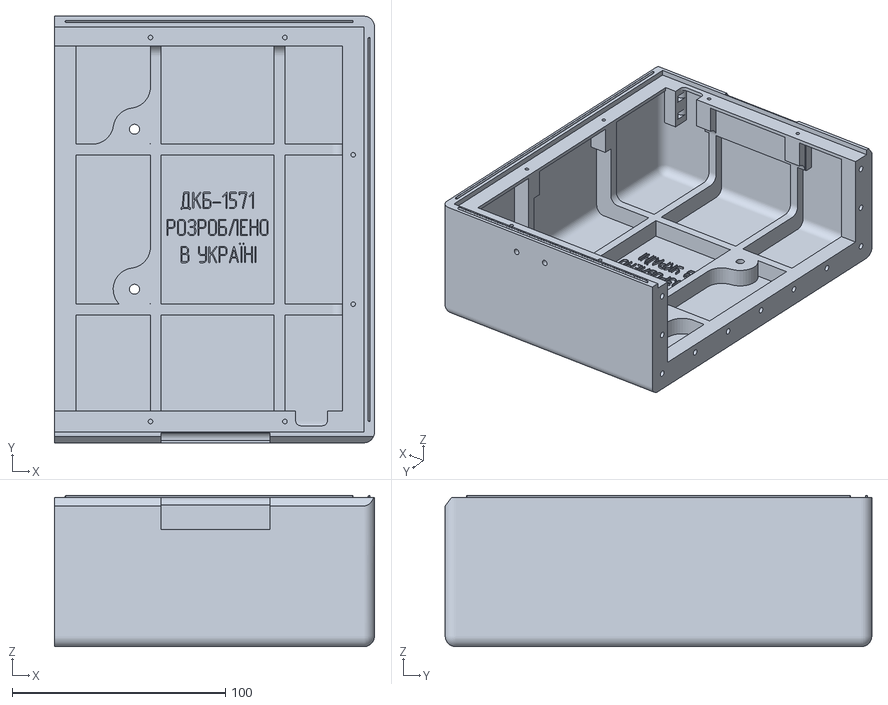
[picture p37: CAD file, 2026-02-28]
Універсальний кейс та корпус станції/STL/Деталь 2 кришка кейсу верхня права.STL
150.0 x 200.0 x 71.0
