ExperimentalDesignBureau-1571/fpv-ground-control-station/Блоки_VRX/Блок_на_базі_VRX_Readytosky_1.2G_1.3G/STL/Деталь_4_шток_перемикання_каналів.STL

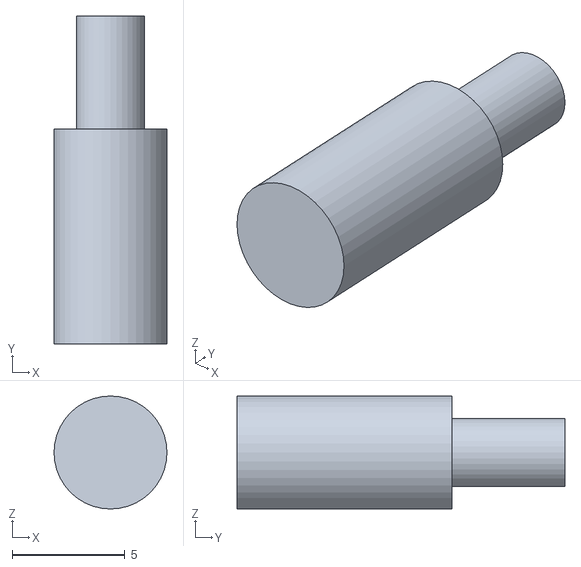
[picture p38: CAD file, 2026-05-03]
Блоки_VRX/Блок_на_базі_VRX_Readytosky_1.2G_1.3G/STL/Деталь_4_шток_перемикання_каналів.STL
5.00 x 14.5 x 5.00
