ExperimentalDesignBureau-1571/fpv-ground-control-station/Виносний_блок/Концентратор_виносного_блоку/STL/Деталь_2_кришка_концентратора_виносного_блоку.STL

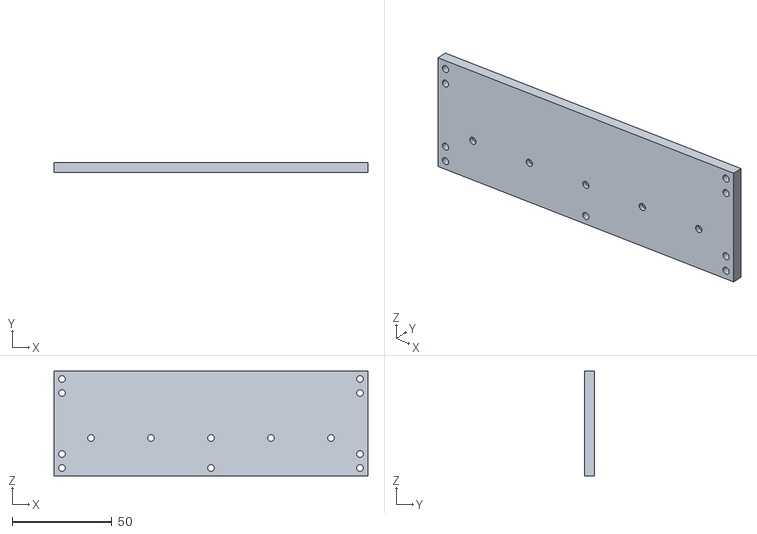
[picture p39: CAD file, 2026-04-06]
Виносний_блок/Концентратор_виносного_блоку/STL/Деталь_2_кришка_концентратора_виносного_блоку.STL
157.0 x 5.00 x 52.5
