ExperimentalDesignBureau-1571/fpv-ground-control-station/Виносний_блок/Універсальна_рамка/STL/Деталь_2_підставка.STL

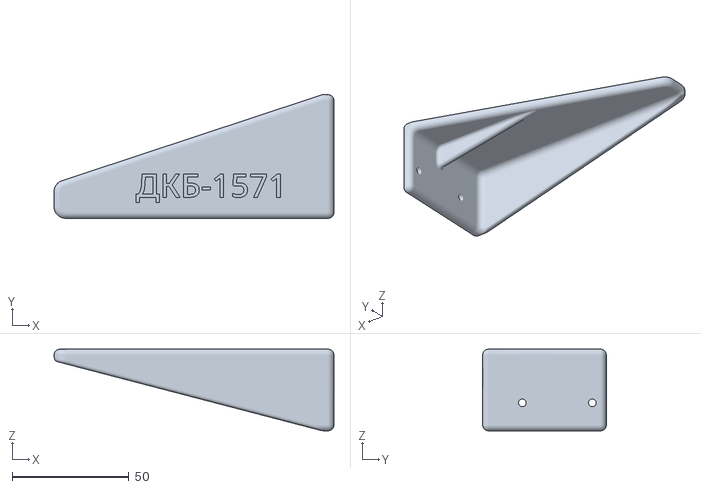
[picture p40: CAD file, 2026-04-06]
Виносний_блок/Універсальна_рамка/STL/Деталь_2_підставка.STL
120.0 x 53.0 x 35.0
