ExperimentalDesignBureau-1571/fpv-ground-control-station/Універсальний кейс та корпус станції/STL/Деталь 5 основа кейсу нижня ліва.STL

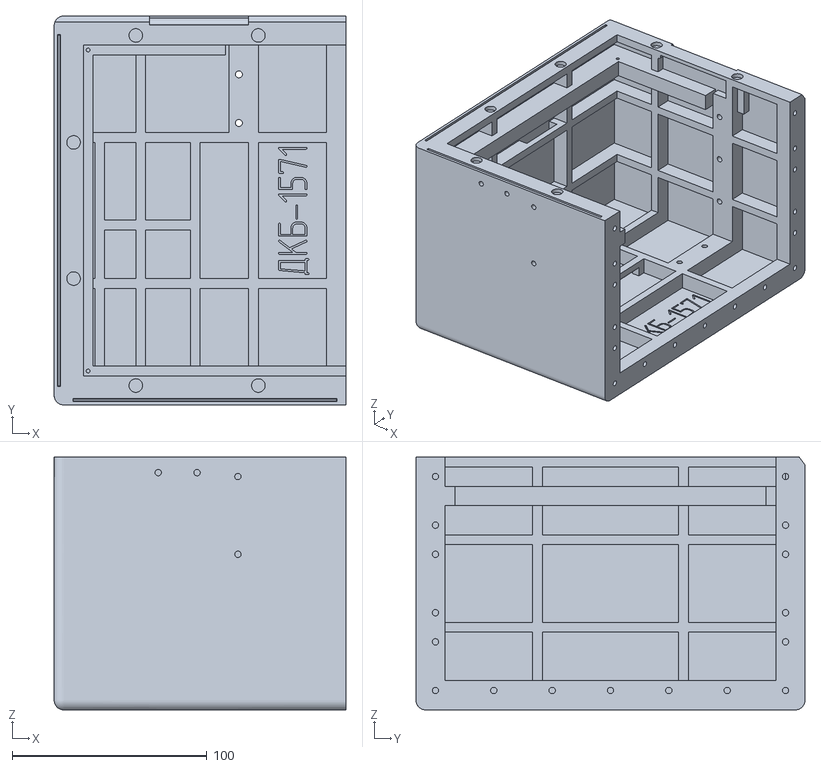
[picture p41: CAD file, 2026-02-28]
Універсальний кейс та корпус станції/STL/Деталь 5 основа кейсу нижня ліва.STL
150.0 x 200.0 x 130.0
