ExperimentalDesignBureau-1571/fpv-ground-control-station/Блоки_VRX/Блок_на_базі_VRX_Readytosky_1.2G_1.3G/STL/Деталь_3_маскувальна_кришка.STL

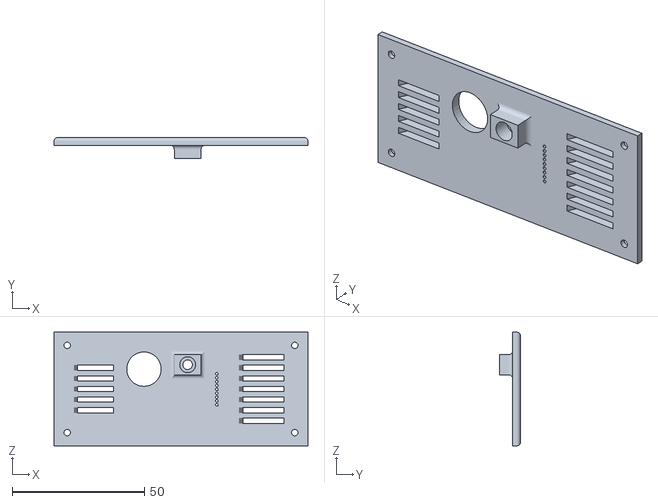
[picture p42: CAD file, 2026-04-28]
Блоки_VRX/Блок_на_базі_VRX_Readytosky_1.2G_1.3G/STL/Деталь_3_маскувальна_кришка.STL
96.0 x 8.00 x 43.0
