ExperimentalDesignBureau-1571/fpv-ground-control-station/Виносний_блок/Концентратор_виносного_блоку/STL/Деталь_4_плата_концентратора.STL

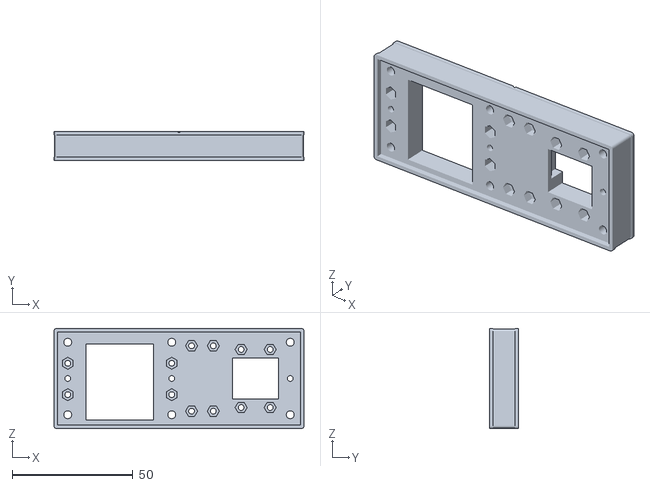
[picture p44: CAD file, 2026-04-06]
Виносний_блок/Концентратор_виносного_блоку/STL/Деталь_4_плата_концентратора.STL
103.4 x 12.0 x 41.4
