ExperimentalDesignBureau-1571/fpv-ground-control-station/Виносний_блок/Універсальна_рамка/STL/Деталь_1_рамка_виносного_блоку.STL

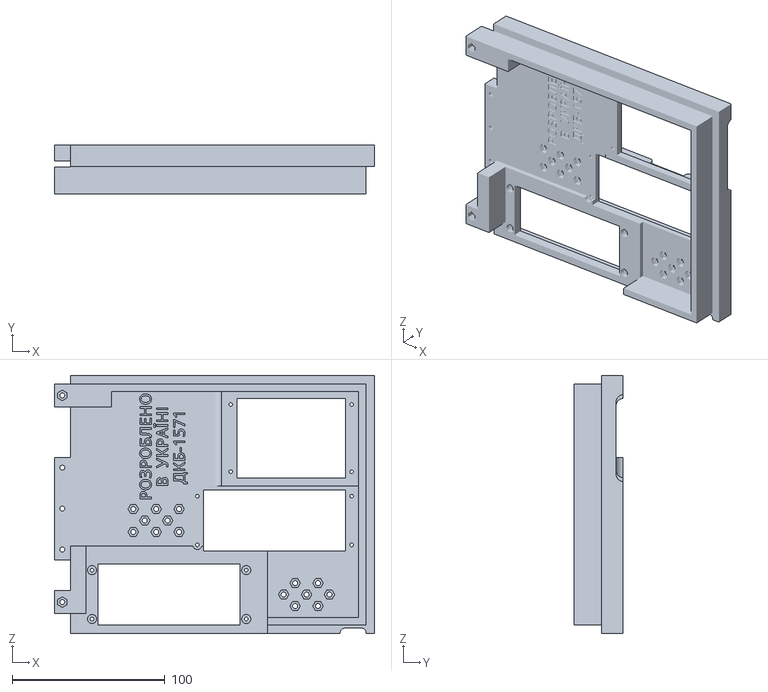
[picture p45: CAD file, 2026-04-06]
Виносний_блок/Універсальна_рамка/STL/Деталь_1_рамка_виносного_блоку.STL
209.6 x 32.0 x 169.0
