ExperimentalDesignBureau-1571/fpv-ground-control-station/Виносний_блок/Концентратор_виносного_блоку/STL/Деталь_1_основа_концентратора_виносного_блоку.STL

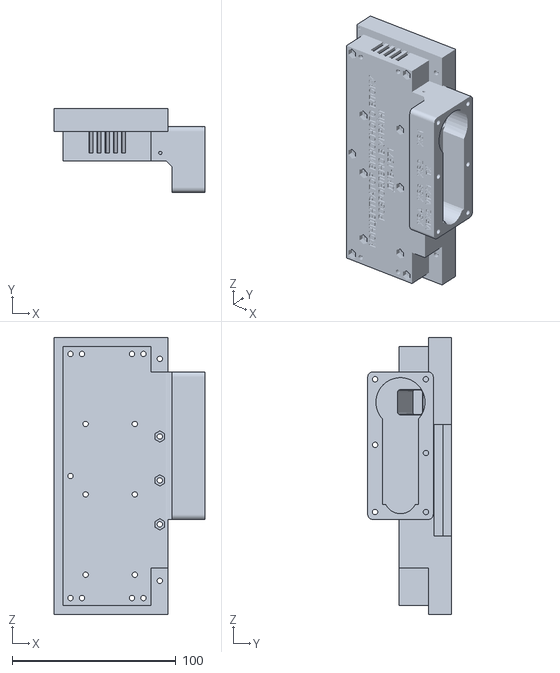
[picture p46: CAD file, 2026-04-06]
Виносний_блок/Концентратор_виносного_блоку/STL/Деталь_1_основа_концентратора_виносного_блоку.STL
92.0 x 51.0 x 169.0
