ExperimentalDesignBureau-1571/fpv-ground-control-station/Виносний_блок/Універсальна_рамка/STL/Деталь_4_фіксатор_антен.STL

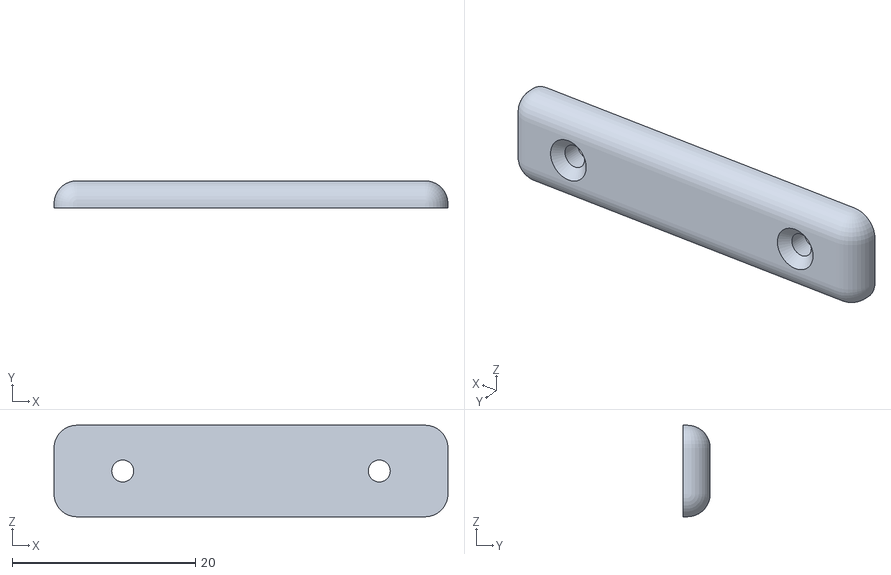
[picture p47: CAD file, 2026-04-06]
Виносний_блок/Універсальна_рамка/STL/Деталь_4_фіксатор_антен.STL
43.0 x 3.00 x 10.0
