ExperimentalDesignBureau-1571/fpv-ground-control-station/Універсальний кейс та корпус станції/STL/Деталь 3 декоративна панель монітора ліва.STL

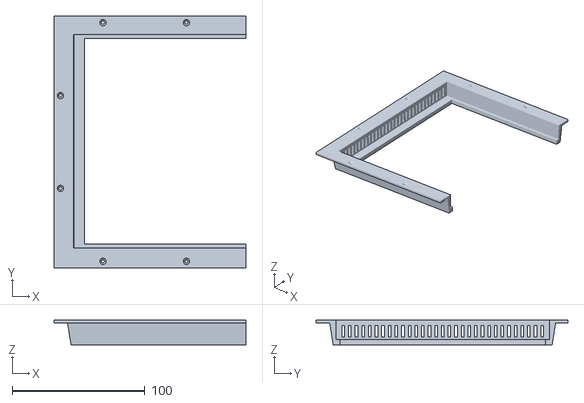
[picture p48: CAD file, 2026-02-17]
Універсальний кейс та корпус станції/STL/Деталь 3 декоративна панель монітора ліва.STL
144.8 x 189.8 x 18.5
