ExperimentalDesignBureau-1571/fpv-ground-control-station/Універсальний кейс та корпус станції/STL/Деталь 9 ручка кейсу.STL

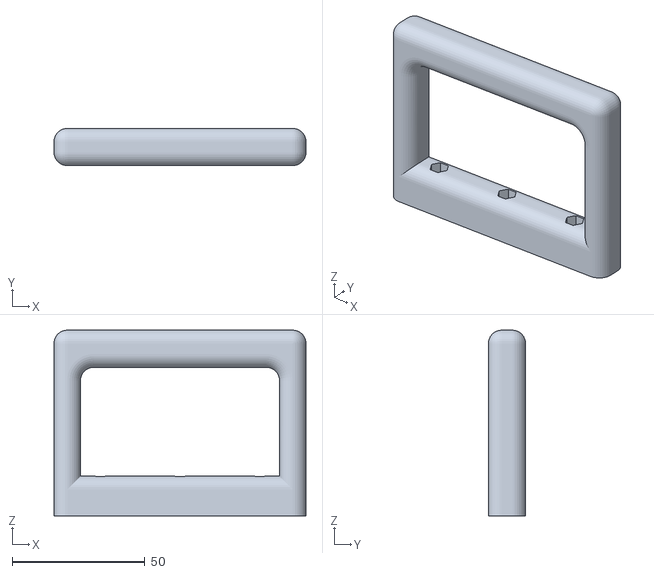
[picture p49: CAD file, 2026-02-17]
Універсальний кейс та корпус станції/STL/Деталь 9 ручка кейсу.STL
95.0 x 14.0 x 70.0
