ExperimentalDesignBureau-1571/fpv-ground-control-station/Універсальний кейс та корпус станції/STL/Деталь 7 тримач ручки кейсу.STL

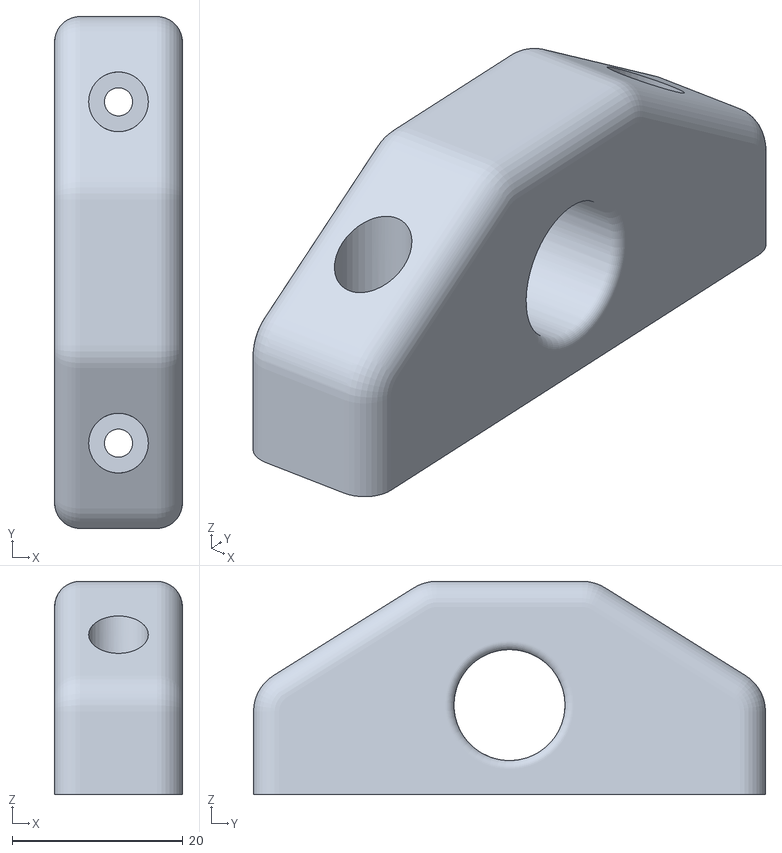
[picture p50: CAD file, 2026-02-17]
Універсальний кейс та корпус станції/STL/Деталь 7 тримач ручки кейсу.STL
15.0 x 60.0 x 25.0
