ExperimentalDesignBureau-1571/fpv-ground-control-station/Універсальний кейс та корпус станції/STL/Деталь 8 вісь ручки кейсу.STL

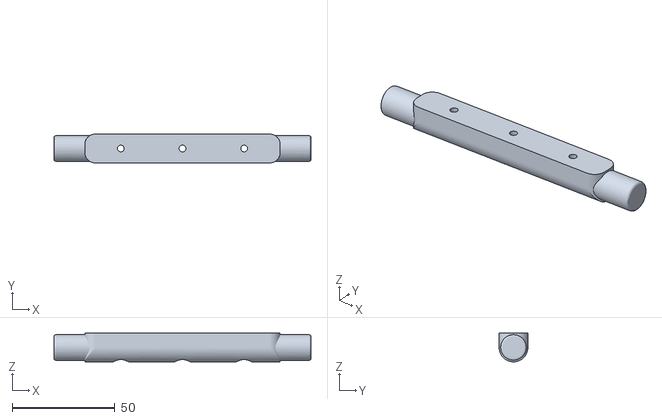
[picture p51: CAD file, 2026-02-17]
Універсальний кейс та корпус станції/STL/Деталь 8 вісь ручки кейсу.STL
125.0 x 14.0 x 14.0
