ExperimentalDesignBureau-1571/fpv-ground-control-station/(list of files, cad)

Other CAD files:
Блоки_VRX/Блок_на_базі_VRX_SKYZONE_SteadyView_X_5G/STL/Деталь_1_основа_блоку.STL
Універсальний кейс та корпус станції/STL/Деталь 1 кришка кейсу верхня ліва.STL
Універсальний кейс та корпус станції/STL/Деталь 6 основа кейсу нижня права.STL
Універсальний кейс та корпус станції/STL/Деталь 4 декоративна панель монітора права.STL
