ExperimentalDesignBureau-1571/fpv-ground-control-station/(list of files, drawings)

Other design files:
Блок_керування_станцією/pcb-layout/power-bus-board.lay6
Виносний_блок/Концентратор_виносного_блоку/pcb-layout/power-bus-board.lay6
